juandiazainscough/FrameWork-Soldadoras/PCB/esquematico3.pdf

## AMS1117

# C10 GND

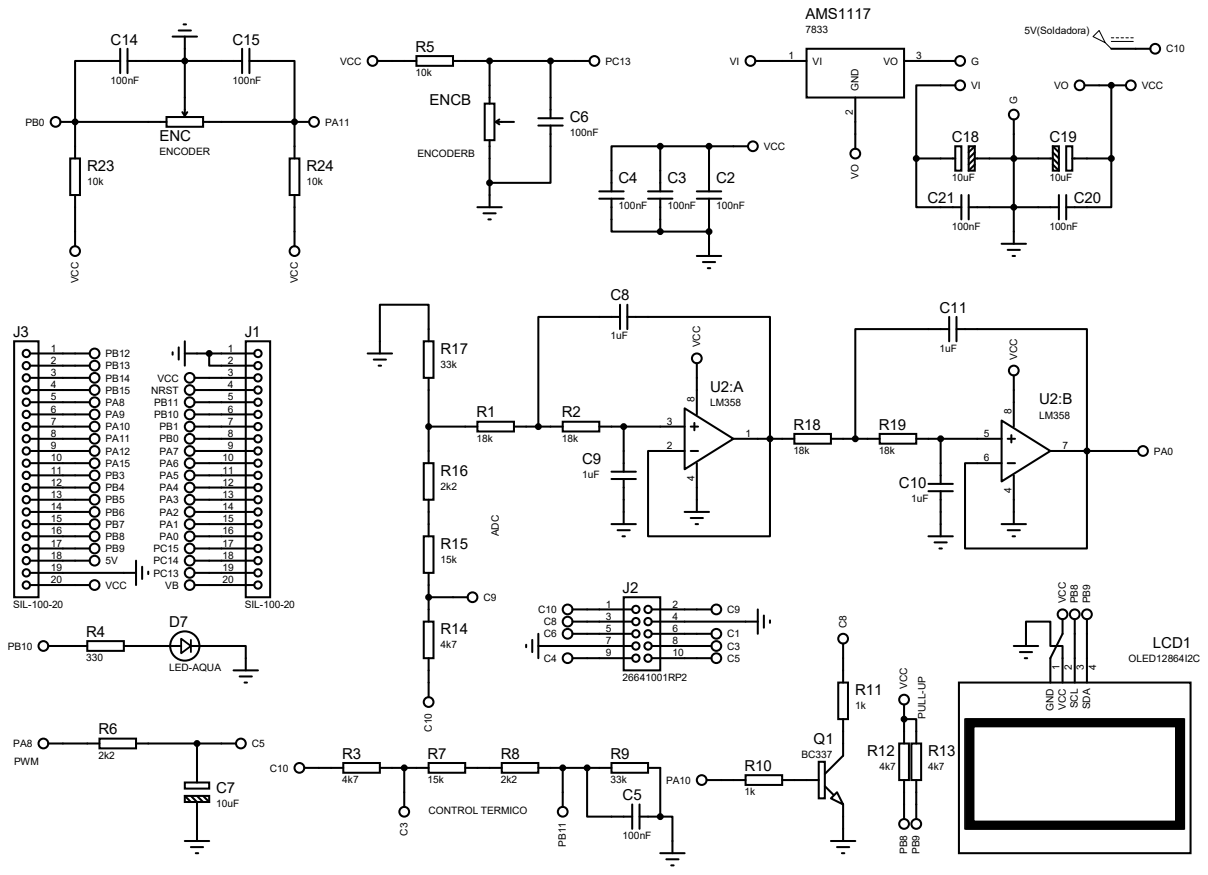
[picture p1: page 1]

4k7 VCC PULL⁻UP C¹⁰
