juandiazainscough/FrameWork-Soldadoras/PCB/componentes3.pdf

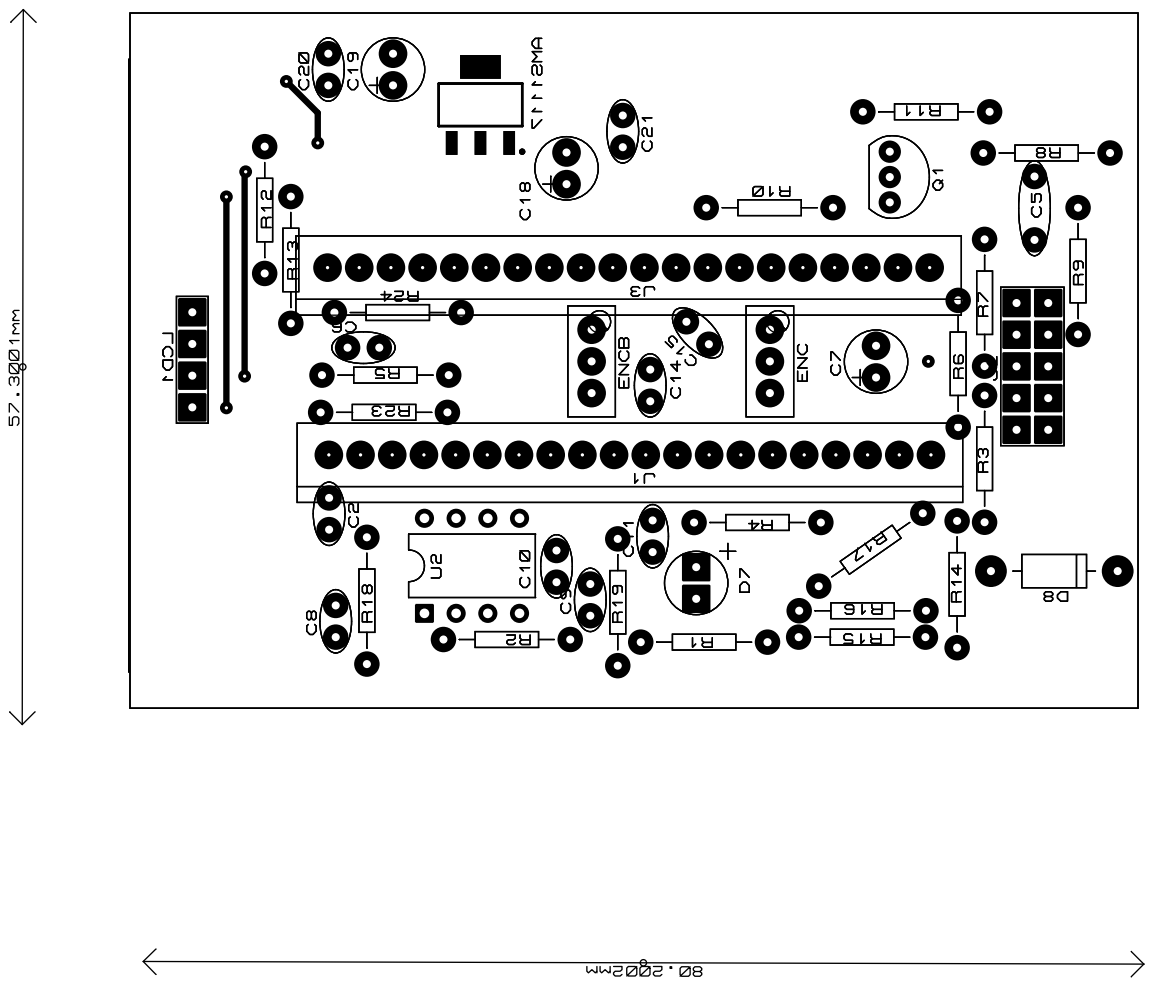
[picture p2: page 1]
