juandiazainscough/FrameWork-Soldadoras/PCB/pcb3.pdf

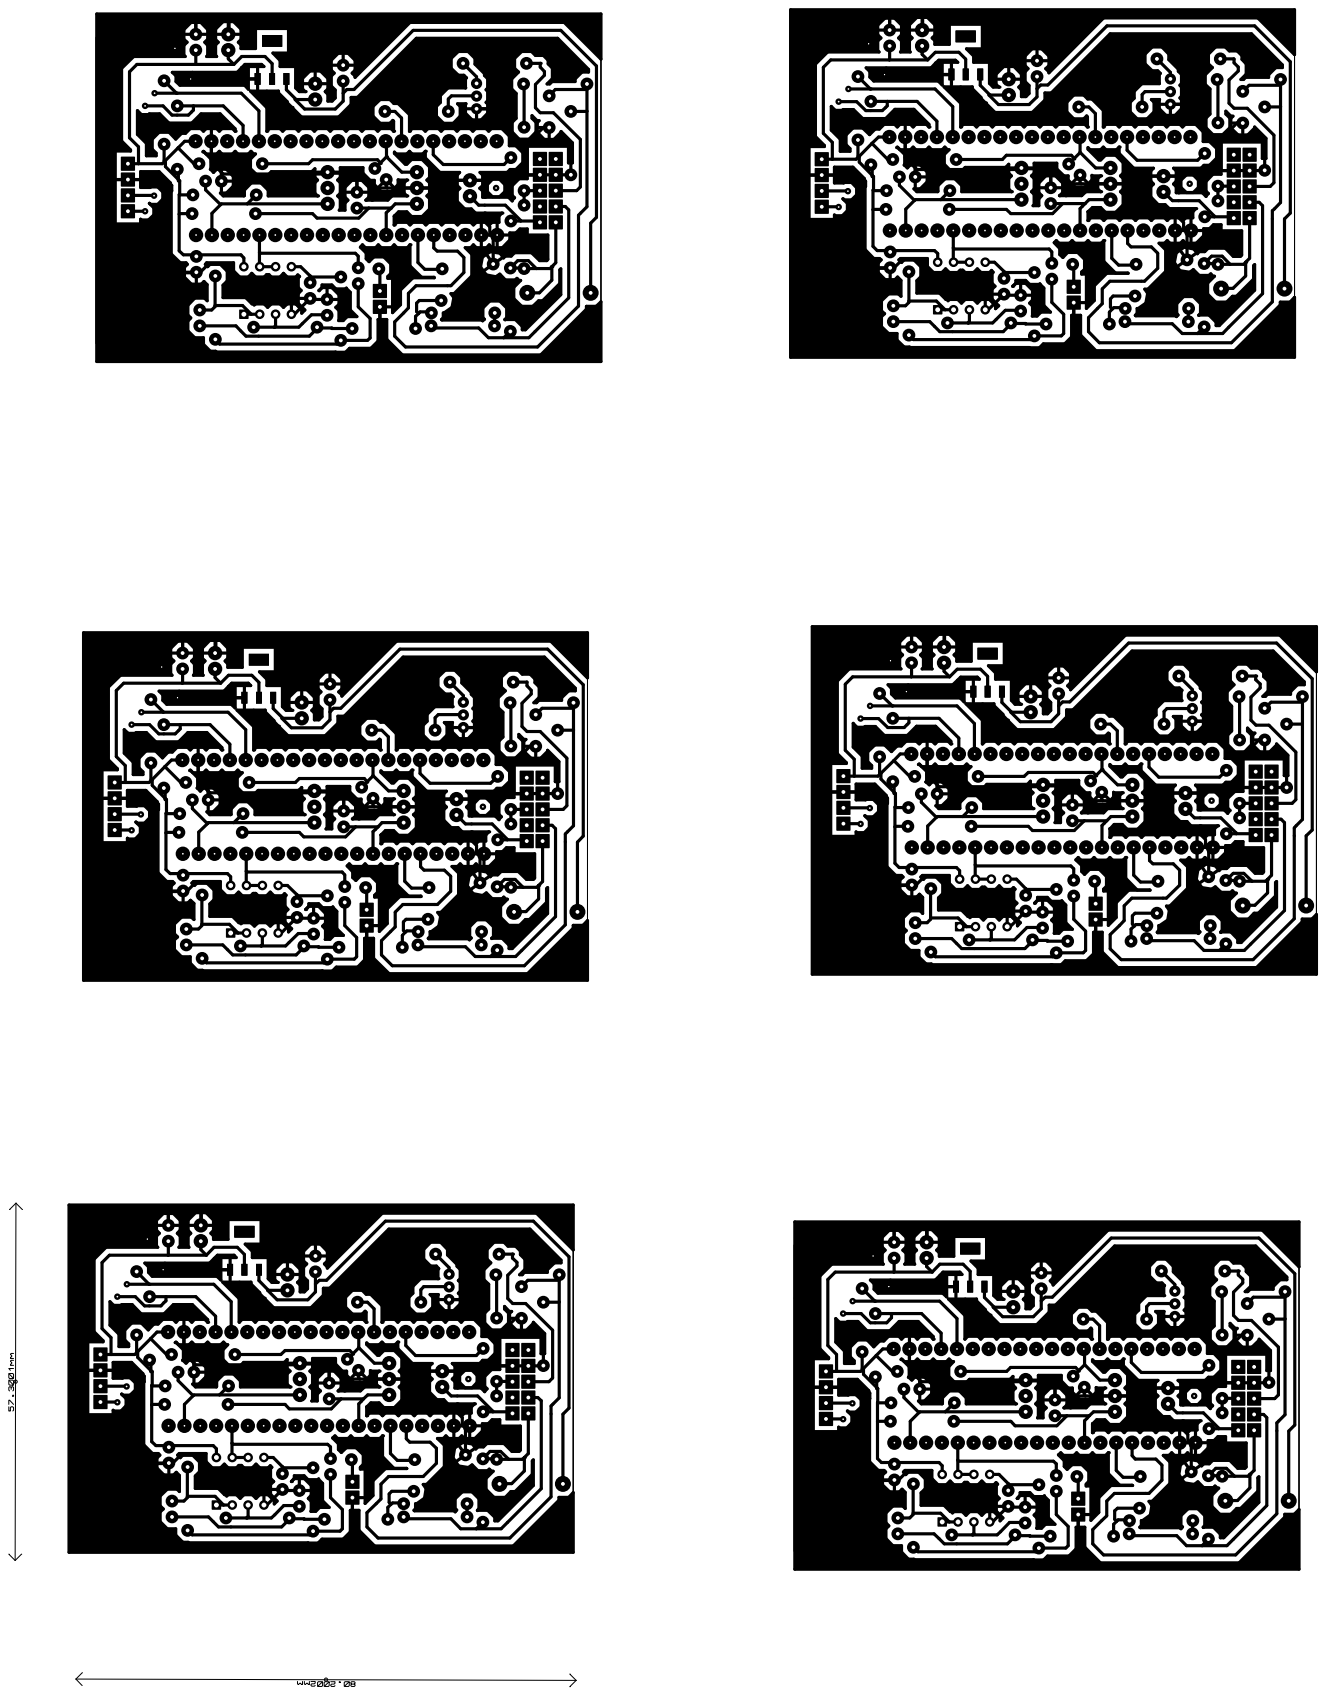
[picture p3: page 1]
