juandiazainscough/FrameWork-Soldadoras/(list of files, drawings)

Other design files:
Iron300Black.pdsprj
