juandiazainscough/FrameWork-Soldadoras/Core/Inc/main.h

#define TEC1_Pin GPIO_PIN_13
#define TEC1_GPIO_Port GPIOC
#define EIZQ_Pin GPIO_PIN_14
#define EIZQ_GPIO_Port GPIOC
#define EDER_Pin GPIO_PIN_15
#define EDER_GPIO_Port GPIOC
#define ENCB_Pin GPIO_PIN_0
#define ENCB_GPIO_Port GPIOB
#define LED1_Pin GPIO_PIN_10
#define LED1_GPIO_Port GPIOB
#define TERMIC_Pin GPIO_PIN_11
#define TERMIC_GPIO_Port GPIOB
#define DG_Pin GPIO_PIN_10
#define DG_GPIO_Port GPIOA
#define ENCA_Pin GPIO_PIN_11
#define ENCA_GPIO_Port GPIOA
#define FTest_Pin GPIO_PIN_12
#define FTest_GPIO_Port GPIOA
